keeganbess/Cancer-Biopsy-Project/Weekly Meetings/Meeting 2_2_22.pdf

Keegan Bess
February 2, 2022
Weekly Meeting 2/2/22

Weekly Recap(1/26-2/2)
This week I have been working on the circuit and the individual elements that make up the PCB. I worked specifically on testing the motor with the current sensor, mainly just outputting the current and voltages read in by the sensor and outputting to the serial communication within the arduino using this code.

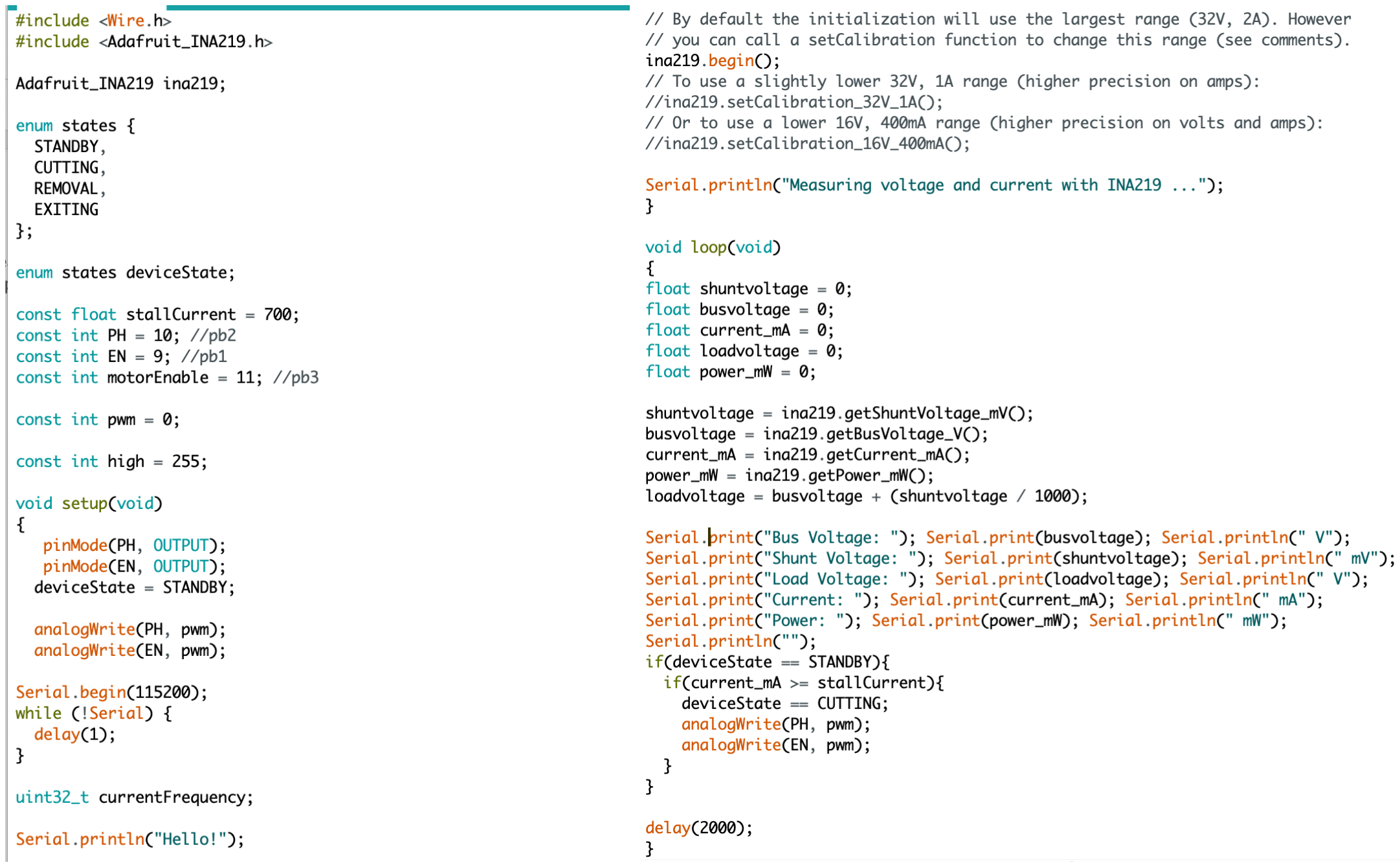
[picture p7: figure]

I got results that were expected which means the connections were accurate and as the motor was moving, I tried manually stalling it to see what the current sensor can read. The motor’s stall current should be 750 mA and when I tested the output you could see the spike of the current measurements from just running to being stalled. The measurement didn’t read 750mA but 665mA and I think that is mainly because I didn’t stall it for long enough with the delay so it showed the spike but because of the delay, it showed the latter part of the spike, therefore I will probably make the delay less time but for testing purposes it was able to demonstrate the spike in current. Therefore changes going forward is to ensure that the current to reach will be a little lower than the expected stlal current but as long as it is significantly over the regular current than the circuit should work fine.

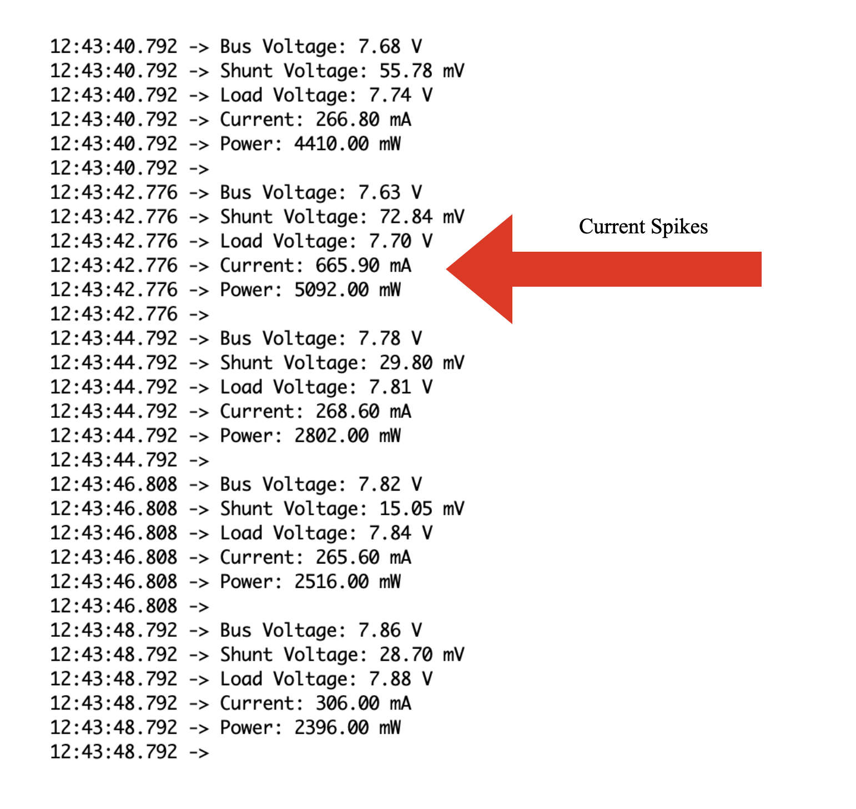
[picture p8: figure]

I started testing the code with the motor driver and the entire circuit, however when I went to program the Arduino micro, the usb port fell off. I just bought a new one online and it should be at my apartment by the time I get home later today. This is a prevalent problem with the arduino micro as the usb isn’t well placed on the board so even the slightest bit of pressure can rip off the usb, especially with the cheaper clones that are found on amazon.

Upcoming Week(2/2/22-2/9/22)
In terms of assignments for my class I have my beta build, beta test plan and progress presentation coming up that I need to work on. I am hoping that with the new arduino coming today I can work with just ensuring all of the connections work as intended and that the code performs the program. With this the PCB can be bought for the beta build and then we can start testing with the pcb and the gelatin by the end of february when it comes in.
