keeganbess/Cancer-Biopsy-Project/Weekly Meetings/Meeting 1_12_22.pdf

Keegan Bess
January 12, 2022

Weekly Recap and Future Plans

- Week Recap(1/5-1/12)
This week I wanted to work on finalizing the parts list and working through the PCB design. I performed a fair bit of research to figure out the parts and read through the documentation of each one, debating between a few things but reaching a final list. Currently I do not have a wireless transceiver completed because I am unsure if there is a part that would fit the current housing. Also, ultimately the data that is wanted is the position of the needle itself so figuring out how to have a wireless transceiver sending position data from the needle itself is a difficult situation. So have to figure out if you want to sacrifice size for a transceiver module or if in this modification there can just be position data through the usb port for now.
Below is the part list that I have compiled together:

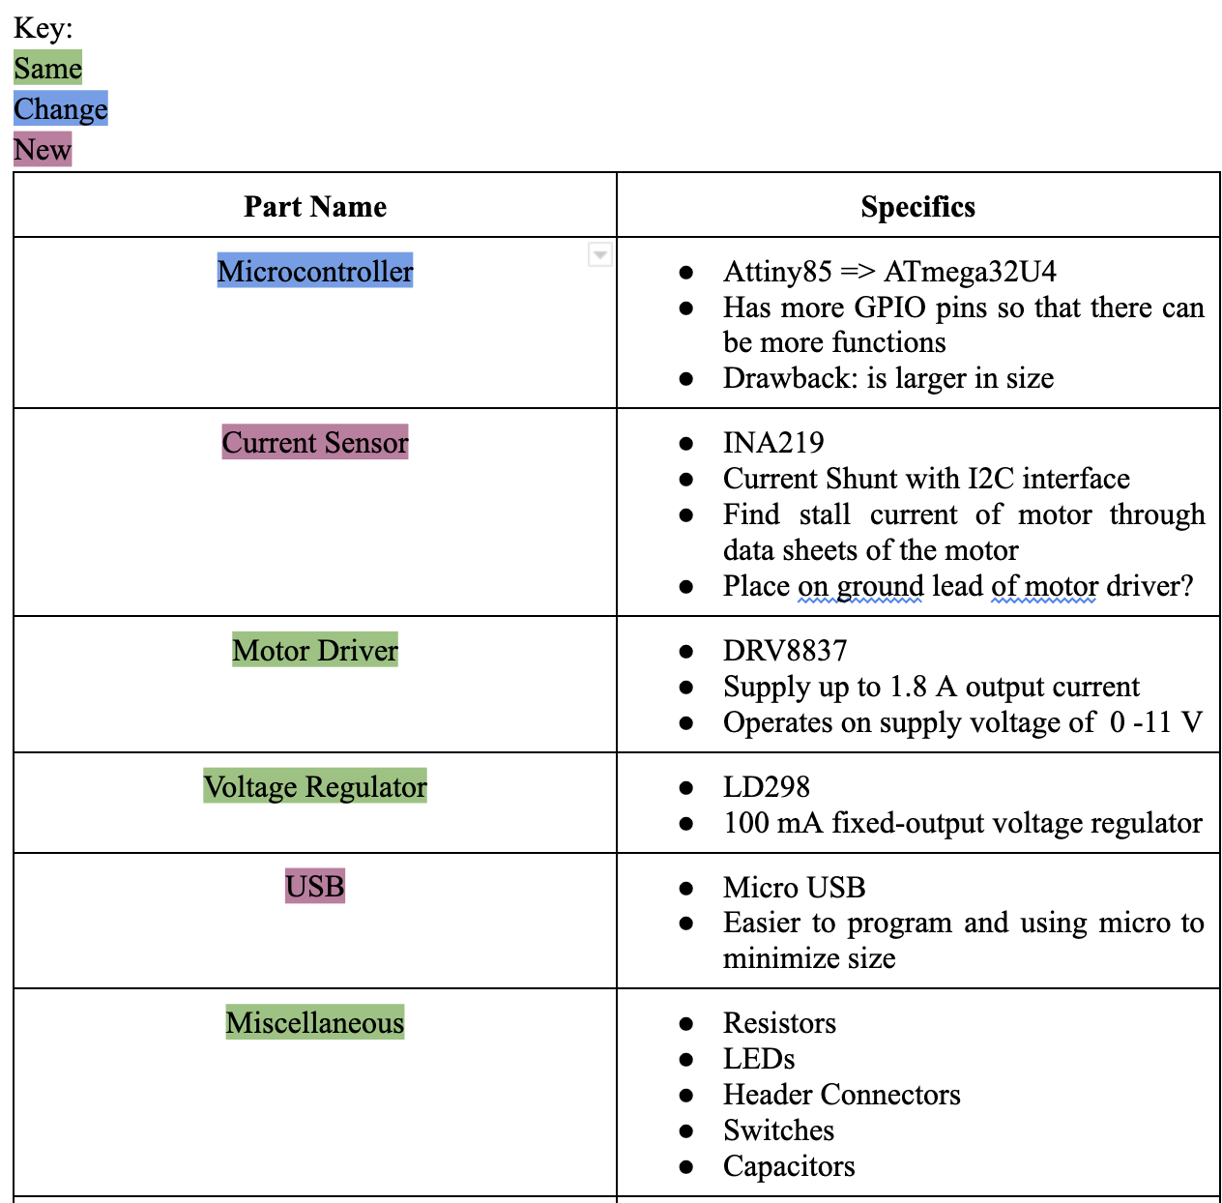
[picture p12: figure]

The following is my current work for PCB, it is unfinished as I’m working on the connections between the motor driver, the microprocessor, the motor and the current sensor. I am planning to go to office hours with a TA so I can ask a few questions and make sure I have the right idea.

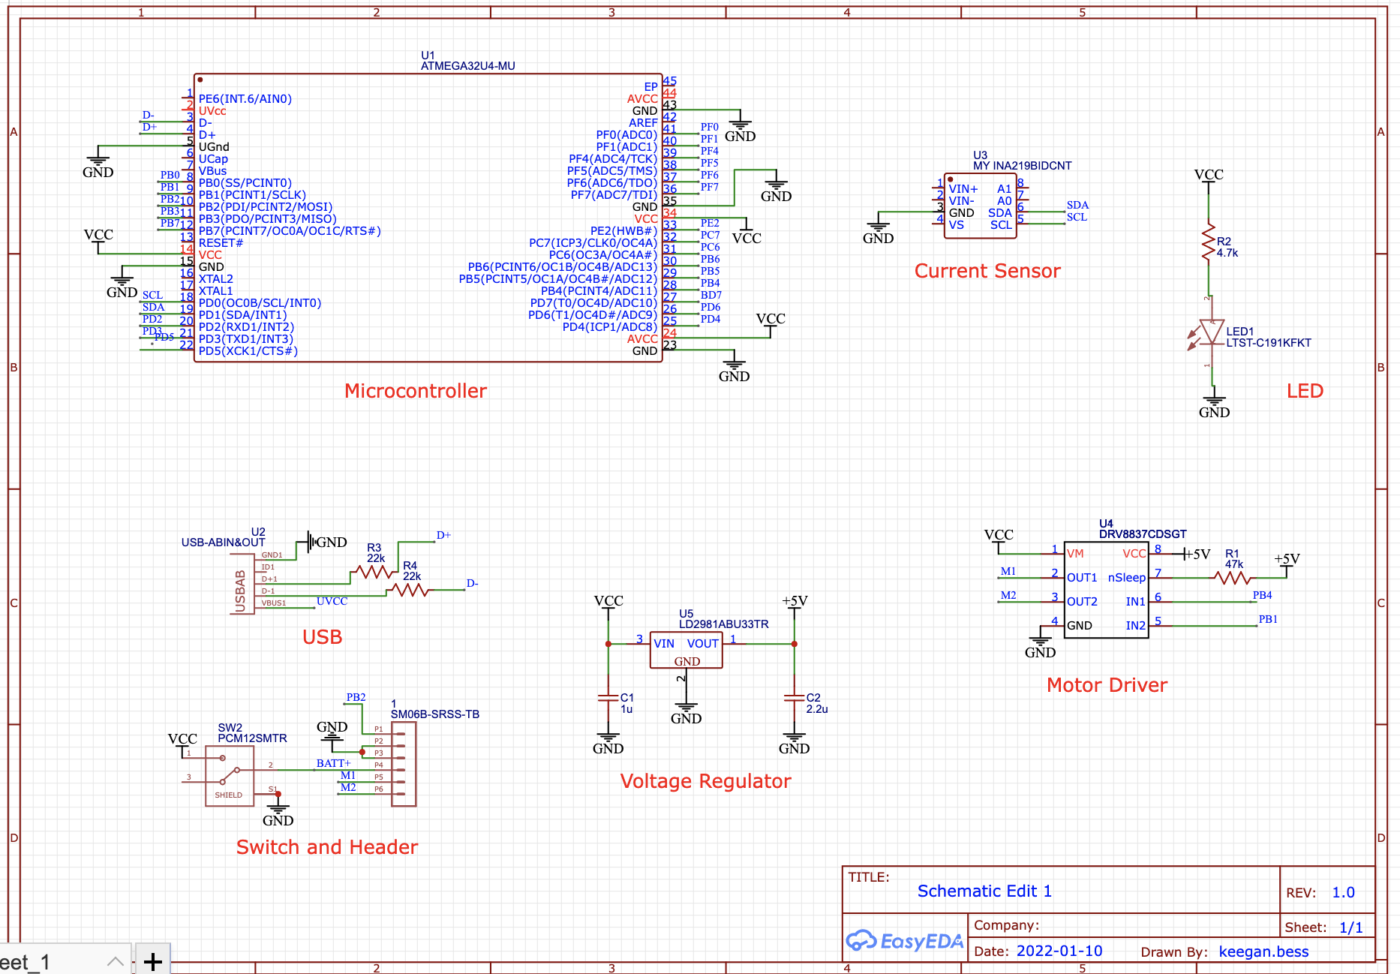
[picture p13: figure]

- Future Plans for Upcoming Week(1/12-1/19)
This week I want to finish my PCB design and get it looked over by the TAs for my class. I have a meeting with my TA tomorrow to discuss my progress and plans for the future weeks and also to ask any additional questions which I plan to discuss the connections between the current sensor with the rest of the circuitry. Once I figure out the PCB design and ensure it will work as intended, then I can purchase everything. I also would like to start working on creating pseudo code for the microcontroller. These changes will specifically be based around the current sensor and working on how to stop the motor based on stall current. To figure this out, I need to either look at the motor documentation to figure out stall current or I can test the motor with a multimeter in the computer engineering lab.
- Important Dates

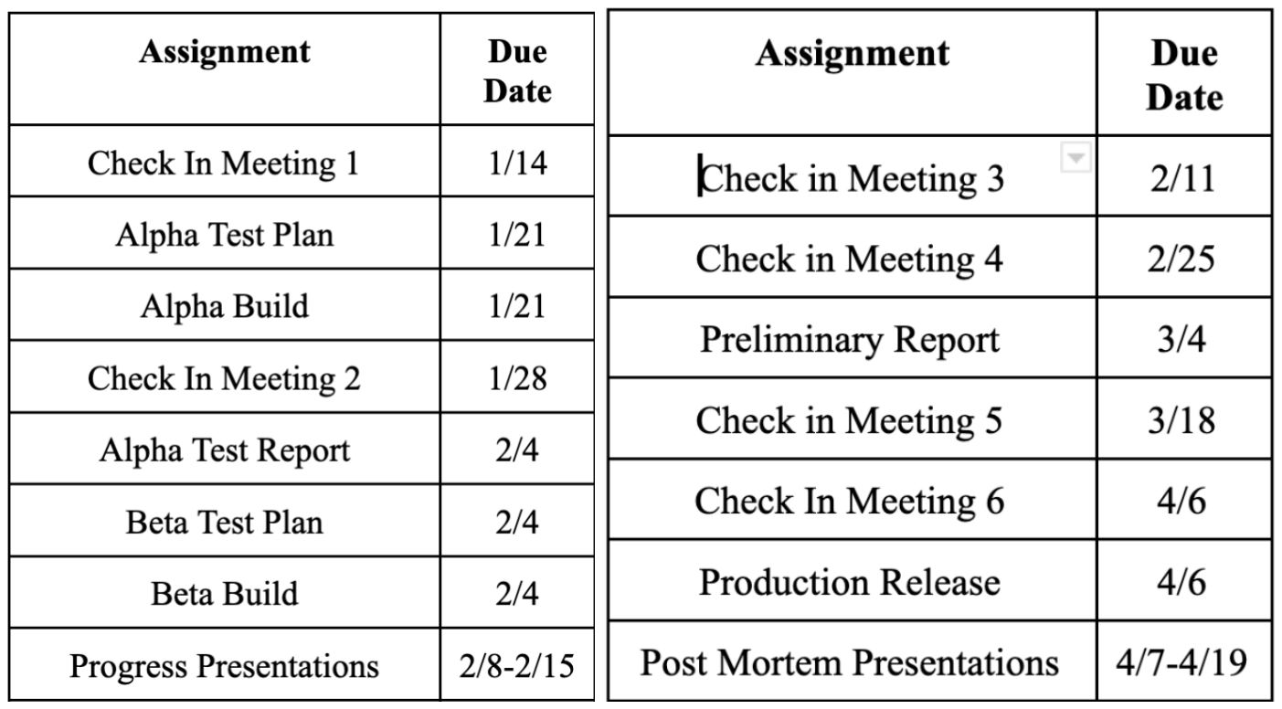
[picture p14: figure]
